gord888/Arduino-GarageDoorOpener/images/arduino.jpg

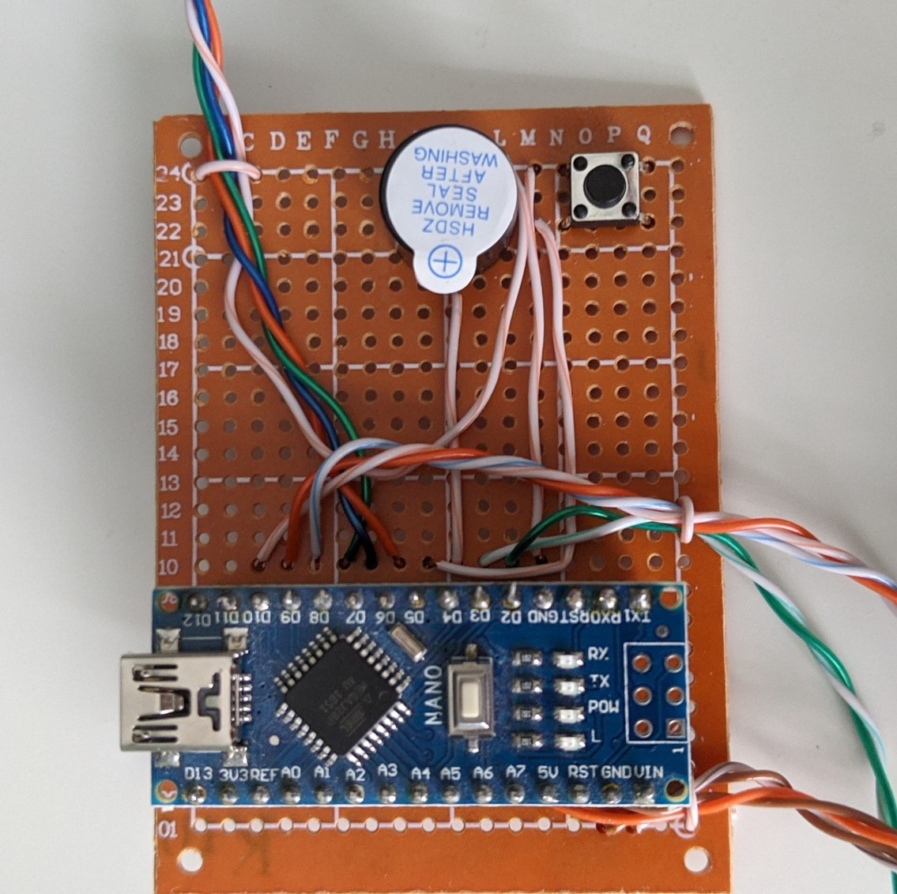
images/arduino.jpg
