gord888/Arduino-GarageDoorOpener/images/garage_door_remote.jpg

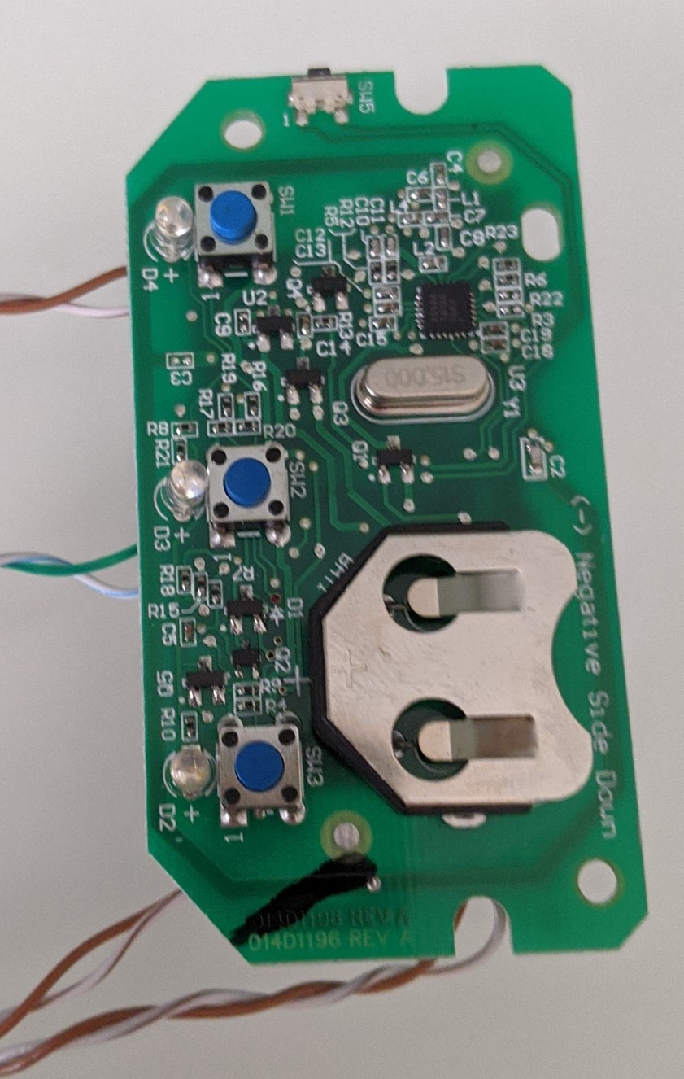
images/garage_door_remote.jpg
