gord888/Arduino-GarageDoorOpener/images/relays.jpg

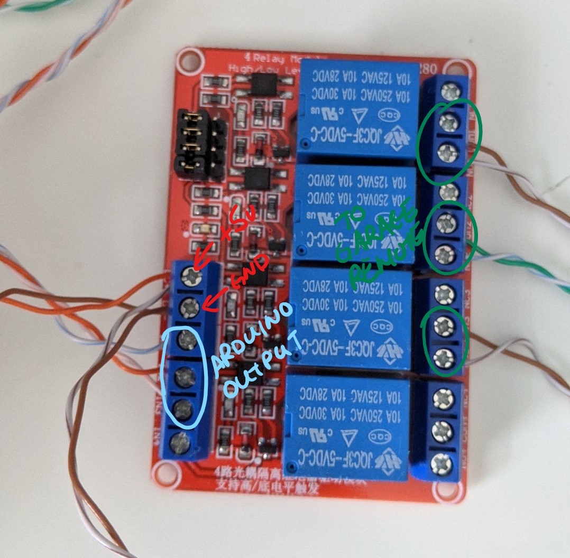
images/relays.jpg
